pappicio/tende-automatiche-esphome/montaggio.jpg

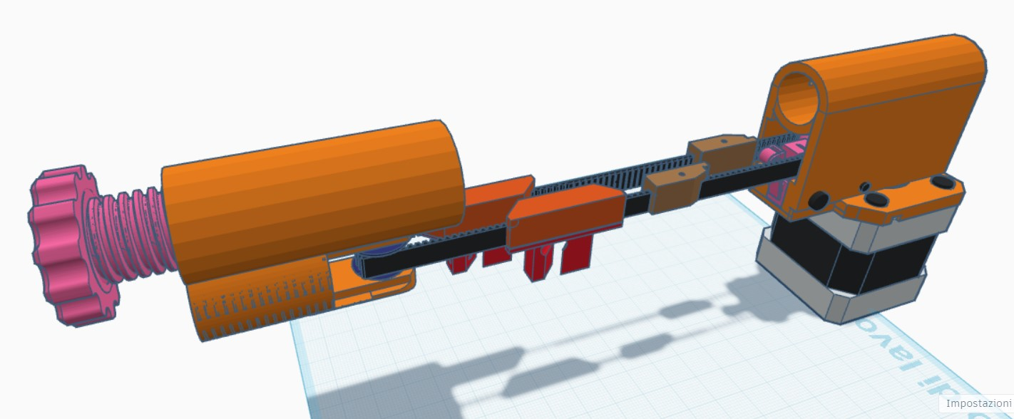
montaggio.jpg
