pappicio/tende-automatiche-esphome/README.md

# tende-automatiche-esphome

montaggio

montaggio2

montaggio3

montaggio4

#hardware:

modulo per stepper driver:

1 x https://it.aliexpress.com/item/1005002915948304.html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

stepper driver (tmc 2208)

1 x https://it.aliexpress.com/item/4000947676742.html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

motore passo passo e cavi

1 x https://it.aliexpress.com/item/1005007660564529.html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

ESP32 C3

1 x https://it.aliexpress.com/item/1005007032546456.html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

2 push button

2 x https://it.aliexpress.com/item/4000164264475.html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

2 switch endstop 

2 x https://it.aliexpress.com/item/1005005924250789.html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

2 pulegge motore stepper

2 x https://it.aliexpress.com/item/1005005647766506.html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

5mt (oppure 10mt) cinghia

1 x https://it.aliexpress.com/item/10000401582873.html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

6 viti da 3mm (4 lunghe 8 mm per sostenere il motore, 2 da 16mm per gli switch endstop)

6 x https://it.aliexpress.com/item/1005002827635096.html

10 viti da legno M2 per 6 o 8 mm

10 x https://it.aliexpress.com/item/1005004177352184.html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

parti stampate:
