pappicio/tende-automatiche-esphome/stampe/readme.md

tutte le viti da 2 vanno avvitate da sotto, quindi gli endstop, i bloccacinghia ecc vanno inseriti dal di sopra della cinghia.
