pappicio/tende-automatiche-esphome/stampe/tiratende2.stl

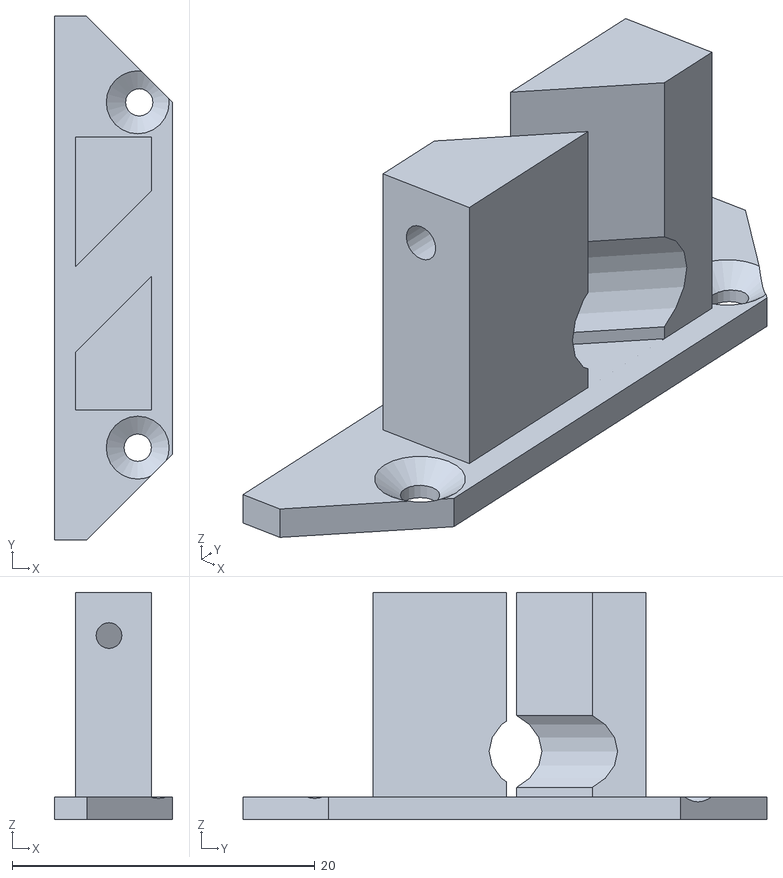
[picture p2: CAD file, 2024-12-30]
stampe/tiratende2.stl
7.80 x 34.6 x 15.0
