pappicio/tende-automatiche-esphome/stampe/endstop2.stl

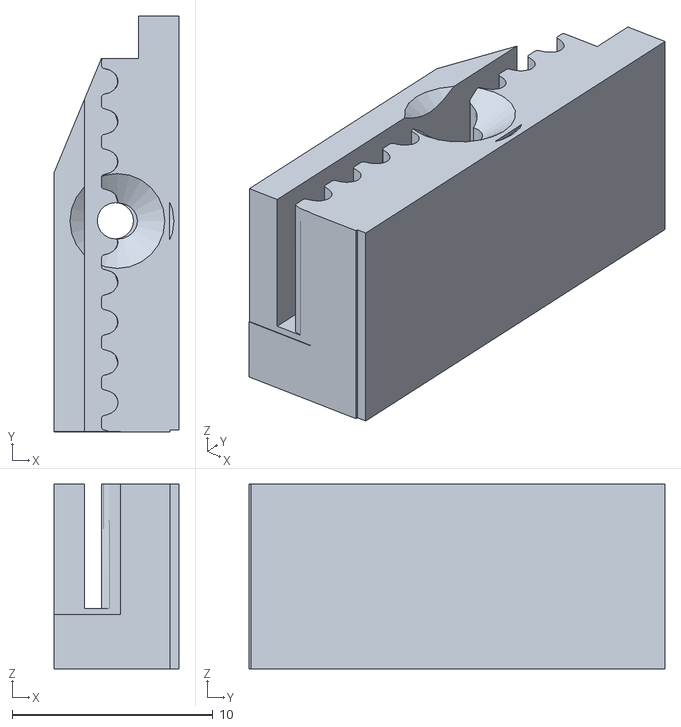
[picture p3: CAD file, 2024-12-30]
stampe/endstop2.stl
6.20 x 20.7 x 9.20
