pappicio/tende-automatiche-esphome/stampe/blocco-cinghia-tiratende1.stl

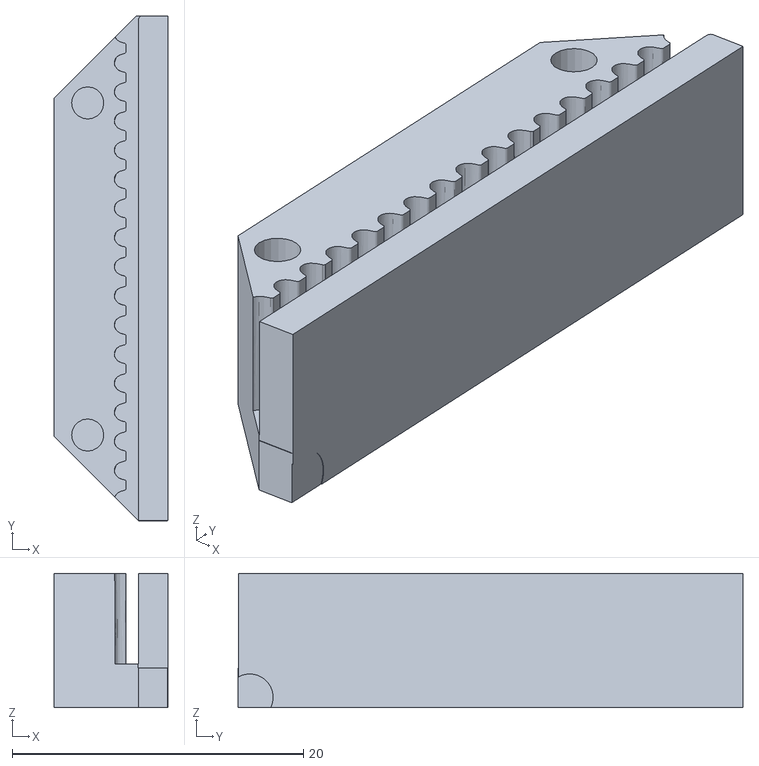
[picture p4: CAD file, 2024-12-30]
stampe/blocco-cinghia-tiratende1.stl
7.80 x 34.7 x 9.20
