pappicio/tende-automatiche-esphome/stampe/spessore-puleggia2.stl

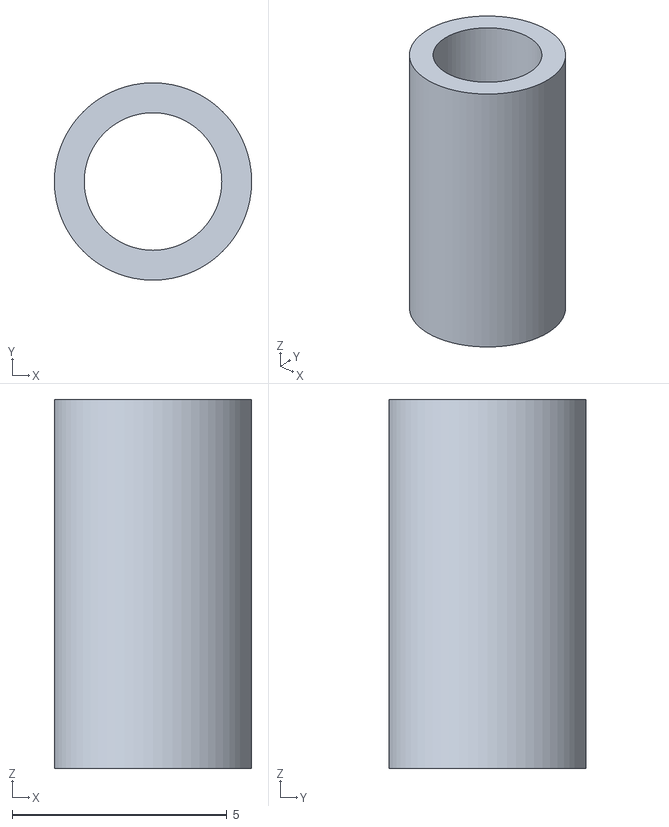
[picture p5: CAD file, 2024-12-30]
stampe/spessore-puleggia2.stl
4.60 x 4.60 x 8.60
