pappicio/tende-automatiche-esphome/stampe/tendicinghia.stl

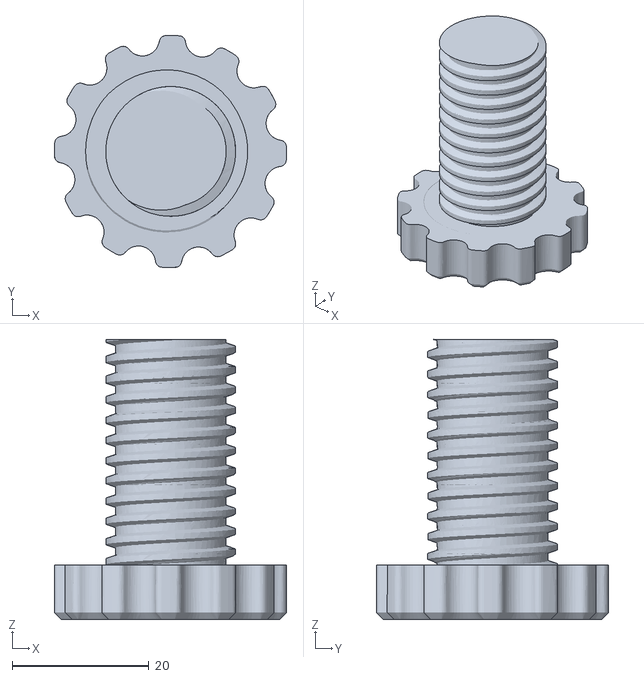
[picture p6: CAD file, 2024-12-30]
stampe/tendicinghia.stl
34.0 x 34.0 x 41.0
