pappicio/tende-automatiche-esphome/stampe/portamotore-endstops.stl

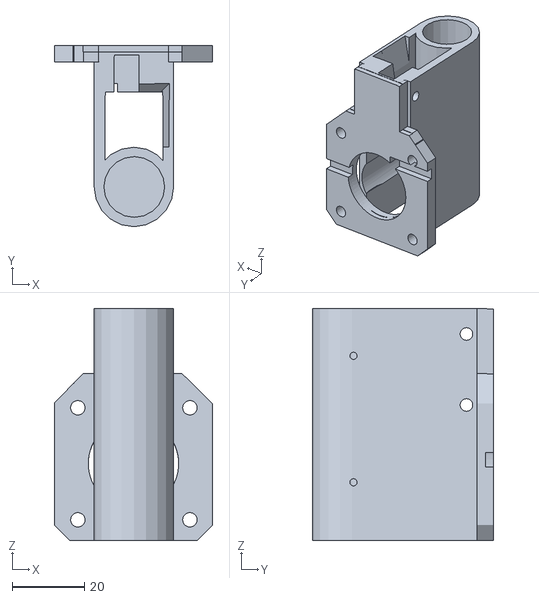
[picture p7: CAD file, 2024-12-30]
stampe/portamotore-endstops.stl
43.8 x 50.2 x 64.2
