pappicio/tende-automatiche-esphome/stampe/tendicinghai-puleggia2.stl

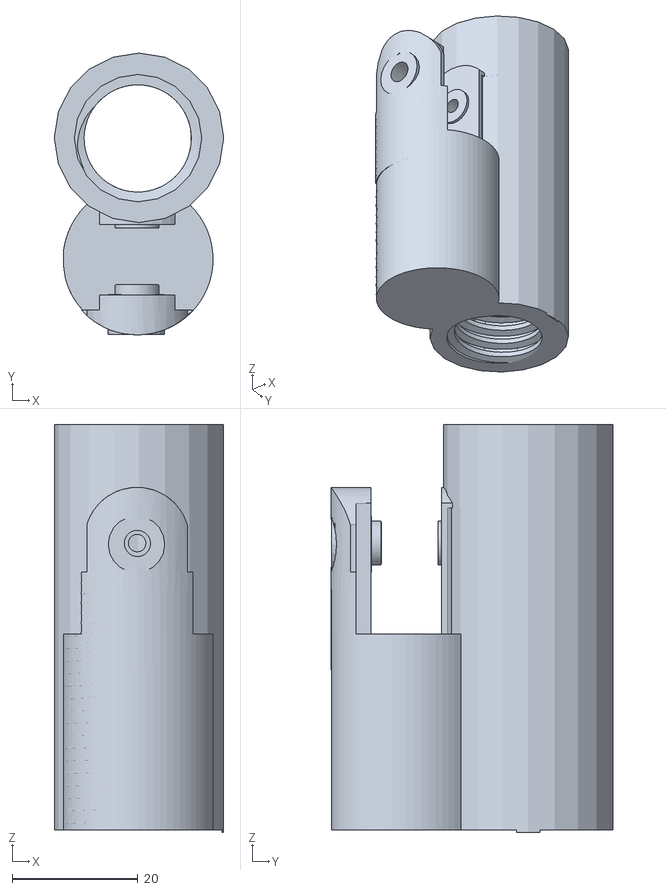
[picture p8: CAD file, 2024-12-30]
stampe/tendicinghai-puleggia2.stl
27.0 x 44.9 x 65.0
