pappicio/tende-automatiche-esphome/(list of files, cad)

Other CAD files:
stampe/endstop1.stl
stampe/tiratende2-alternativa.stl
stampe/blocco-cinghia-tiratende2.stl
stampe/tiratende1.stl
stampe/tiratende1-alternativa.stl
